eried/pidflight-lap-firmware/README.md

# PIDflight ESP32 edition

## Demo video
Youtube (https://www.youtube.com/watch?v=CKgIOPRDrkA)

## Build one
[See details here](ESP32.md)

## Official website
https://www.pidflight.com/pidflight-lap/
