eried/pidflight-lap-firmware/images/layout.PNG

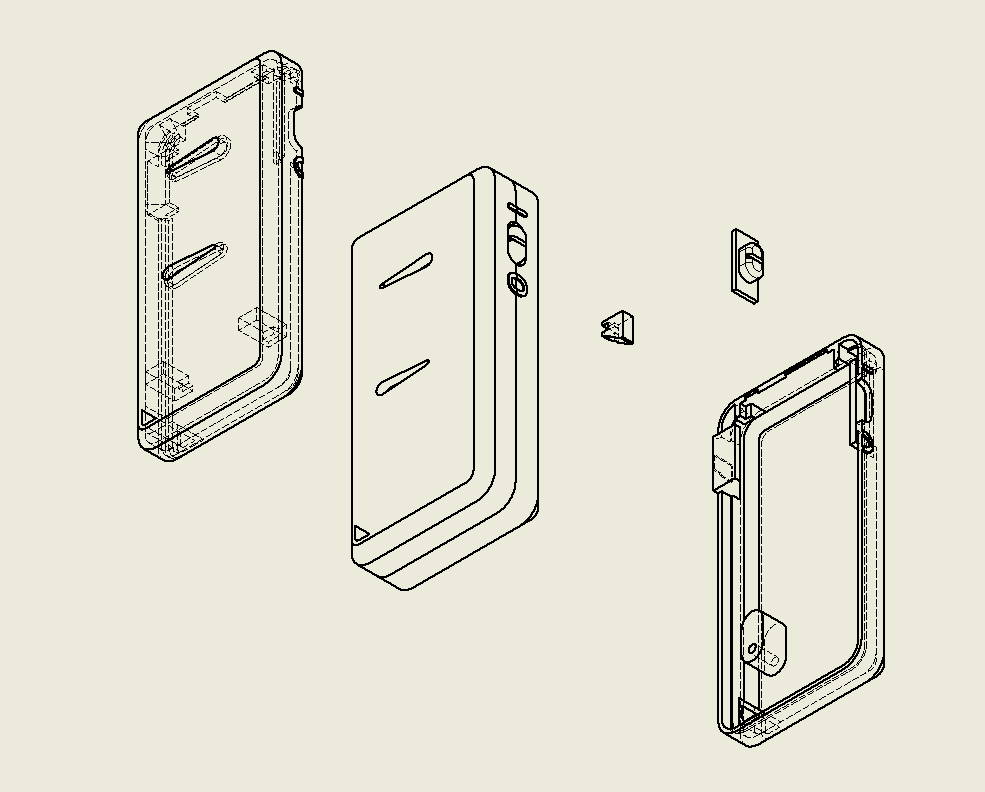
images/layout.PNG
