eried/pidflight-lap-firmware/(list of files, cad)

Other CAD files:
case/v1_final/layout.dwg
case/v1_final/OldVersions/case.0007.iam
case/v1_final/OldVersions/down.0009.ipt
case/v1_final/OldVersions/switch_internal.0001.ipt
case/v1_final/OldVersions/up.0006.ipt
case/v1_final/case.iam
case/v1_final/down.ipt
case/v1_final/switch_internal.ipt
case/v1_final/switch_slider.ipt
case/v1_final/up.ipt
case/v1_prototype/OldVersions/case.0007.ipt
case/v1_prototype/OldVersions/case.0009.iam
case/v1_prototype/OldVersions/case_down.0017.ipt
case/v1_prototype/OldVersions/case_up.0012.ipt
case/v1_prototype/OldVersions/esp32_t8.0002.ipt
case/v1_prototype/OldVersions/switch.0001.ipt
case/v1_prototype/OldVersions/switch_a.0006.ipt
case/v1_prototype/OldVersions/switch_b.0005.ipt
case/v1_prototype/case.iam
case/v1_prototype/case.ipt
case/v1_prototype/case_down.ipt
case/v1_prototype/case_up.ipt
case/v1_prototype/esp32_t8.ipt
case/v1_prototype/lipo.ipt
case/v1_prototype/rx5808.ipt
case/v1_prototype/switch.ipt
case/v1_prototype/switch_a.ipt
case/v1_prototype/switch_b.ipt
