eried/pidflight-lap-firmware/(commit log)

2020-03-14 Support for TTGO-T8-ESP32
    https://github.com/LilyGO/TTGO-T8-ESP32
2020-03-15 Watchdog to prevent hangs
    [pidflight_lap.ino]
2020-03-16 Case fixes
    [case.0008.iam, case.0009.iam, case.iam, case_down.0008.ipt, case_down.0012.ipt, case_down.ipt, case_down.stl, case_up.0008.ipt]
2020-03-16 Buzzer for the ESP32
    [const.h, pidflight_lap.ino]
2020-03-16 Case assembly
2020-03-16 Slimer switch
    [switch_a.ipt]
2020-03-17 Creating final version of the case with all the fixes
    [case.0005.ipt, case.0006.iam, case.0009.iam, case.iam, case.ipt, case_down.0012.ipt, case_down.0014.ipt, case_down.ipt]
2020-03-17 Output files
    [case_down.stl, case_up.stl, switch_a.stl, switch_b.stl]
2020-03-17 Update to the STL files will be uploaded on Thingiverse
    [case_down.stl, case_switch_internal.stl, case_switch_slider.stl, case_up.stl, switch_a.stl, switch_b.stl]
2020-03-17 New labels
    [case.0005.ipt, case.0006.iam, case.0006.ipt, case.0007.iam, case.iam, case.ipt, case_down.0014.ipt, case_down.0016.ipt]
2020-03-18 Building the case images
2020-03-18 Assembly layout
    [layout.dwg]
2020-03-18 Minor tweaks
    [case.0006.ipt, case.0007.ipt, case.ipt, case_down.0016.ipt, case_down.0017.ipt, case_down.ipt, switch_a.0005.ipt, switch_a.0006.ipt]
